ShXck/KROTIC-Code/InformeTecnico_MarceloSanchez.pdf

# Actualizacion de arquitectura para robot educativo ´ KROTIC

Marcelo Sanchez Solano ´
Area acad ´ | emica de Ingenier ´ | ía en Computadores
| Instituto Tecnologico de Costa Rica ´

Resumen—En este documento se describe el proceso de disenõ
de la solucion para la actualizaci ´ | on de la arquitectura del robot ´
educativo KROTIC. Se plantea que el robot ahora tiene dos niveles de funcionalidad separados y que realizan acciones distintas. El nivel superior maneja la transmision en vivo, procesamiento ´ de programas y mecanismos de control, mientras que el nivel inferior maneja funciones asociadas al movimiento y al uso de sensores. Para la solucion se analizan los factores fundamentales ´ que se deben tener en un robot, que son: costo, comunicacion, ´ sensores, autonomía y capacidad de procesamiento y luego, con base a los resultados se exponen las limitantes que el diseno tiene, ˜
que estan relacionadas al espacio f ´ | ísico, consumo energetico y ´
calidad de transmision en vivo de video. ´

Palabras clave—arquitectura, robot, costo, comunicacion, sen- ´ sores, autonomía y capacidad de procesamiento.

I. INTRODUCCION´
El laboratorio LuTec, que forma parte del Area Acad ´ | emica ´
de Ingeniería en Computadores en el Te, tiene el proyecto
KROTIC, donde el objetivo es ensenar fundamentos de rob ˜ | oti- ´
ca a estudiantes que residen zonas rurales donde al acceso a internet es limitado o de difícil acceso.
El robot KROTIC, es un pequeno cubo que debe ser ˜ programado por los estudiantes para que cruce una pista de
obstaculos. Entonces, el robot puede ser programado a trav ´ | es´
de una aplicacion m ´ | ovil para que el proceso sea lo m ´ | as sencillo ´
posible.
En primera instancia el proyecto se practicaba de forma presencial, donde se visitaban distintas escuelas y los ninos ˜ tenían interaccion directa con el robot que se programaba, pero ´ a raíz de la pandemia estas visitas se suspendieron, lo que llevo al surgimiento de nuevas necesidades de modo que estos ´ estudiantes no suspendan sus estudios en robotica. ´
La solucion que se propone en este documento viene a ´ solucionar parte de las necesidades que surgieron debido a la
pandemia. Es decir, la solucion abarca aspectos como conexi ´ | on´
inalambrica y despliegue de una visualizaci ´ | on a distancia de la ´
vista del robot. Ademas de m ´ | as capacidad de procesamiento y ´
mayor soporte para mas dispositivos como sensores, que viene ´
a dar mas posibilidades para la creaci ´ | on de programas de los ´
estudiantes.

II. ANTECEDENTES
Actualmente, los robots estan presentes en muchas ´ | areas ´
de aplicacion, desde sistemas rob ´ | oticos complejos como los ´
usados en exploraciones espaciales hasta los mas simples, ´ como los utilizados en aplicaciones de limpieza del hogar

[1]. Con el paso del tiempo, la capacidad de procesamiento de microcontroladores o dispositivos similares ha aumentado, mientras al mismo tiempo, su tamano se ha reducido. Esto hace ˜ que cada vez se puedan construir robots de menor tamano y ˜ mas baratos. ´
Asimismo, tales facilidades hacen que sea mas accesible ´
la implementacion de sistemas m ´ | as complejos como robots ´
cooperativos; que son multiples robots que tienen una tarea ´ en comun, pero que la misma tarea es distribuida entre la red ´ ya que sería muy difícil si no imposible de ser ejecutada por un solo robot [2], o enjambres de robots; donde un conjunto de robots forman estructuras similares a las encontradas en la naturaleza (abejas, aves, peces, entre otros) para resolver un problema específico [3], y por supuesto los robots educacionales tambien han tenido sus avances debido a todas las ´ facilidades que se mencionaron que se han desarrollado a lo
largo de los ultimos a ´ | nos. ˜
En [4], se desarrolla una aplicacion de robots enjambre ´
de proposito educativo, donde se ´ | nalan que cualquier robot ˜
educativo debe cumplir los siguientes requisitos:
1. Costo. Los robots deben ser los mas baratos posibles. ´
2. Autonomía. La batería debe ser suficiente para que los robots puedan operar por un largo tiempo.
3. Sistema de sensores. Deben estar equipados por componentes que permitan interactuar con su ambiente y captar eventos en el mismo.
4. Comunicacion. ´ Debe ser capaz de comunicarse con otros robots o con otros agentes externos.
5. Capacidad de procesamiento. Deben ser capaces de procesar la informacion captada por el sistema de sen- ´ sores mencionado.
Todas estas variables se consideraron para el diseno y ˜
seleccion de componentes y se va a detallar en la secci ´ | on´
de resultados.
Ahora, la pregunta es ¿Por que los robots pueden llegar ´ a ser tan relevantes en el area educativa? Los robots son ´ herramientas muy flexibles que pueden colaborar a mejorar el
entendimiento de muchas areas, no solo rob ´ | otica, puede utili- ´
zarse para aprender matematicas, f ´ | ísica, inteligencia artificial,
vision por computadoras, entre muchas otras. La ventaja del ´ aprendizaje asistido por robots es que ayuda a los estudiantes
a fortalecer sus conocimientos a traves de ejercicios pr ´ | acticos ´
[5].
De hecho, Benitti [6], al realizar un estudio sistematico ´ de literatura relacionada al aprendizaje a traves de robots, ´ concluyo que el uso de robots con fines educativos tiene mayor ´

influencia en los estudiantes en dos areas: contribuciones para ´ entender o asimilar conceptos y el desarrollo de habilidades. Por un lado, los descubrimientos de Benitti senalan que, a ˜ traves de ejercicios auto dirigidos promovieron el entendimien- ´ to de conceptos relacionados a la ciencia e ingeniería principalmente. Por otro lado, entre las habilidades desarrolladas se encuentran: i) el desarrollo de pensamiento, que se asocia
al observacion, estimaci ´ | on y manipulaci ´ | on, ii) resoluci ´ | on de ´
problemas, a traves de evaluaci ´ | on, generaci ´ | on de hip ´ | otesis, ´
verificacion de hip ´ | otesis y control de variables y iii) desarrollo ´
del trabajo en equipo.

III. SOLUCION DESARROLLADA ´

La solucion propuesta tiene dos niveles de funcionalidad, ´ que se derivan de los nuevos requerimientos mencionados al inicio, ya que se requiere mayor capacidad de procesamiento y extender las funcionalidades del robot KROTIC. A manera de resumen, el nivel superior de funcionalidad tienen las siguientes funciones:
Capturar videos e imagenes utilizando c ´ | amara USB. ´
Transmitir vía WiFi lo capturado por el modulo de ´ camara hacia los estudiantes en tiempo real. ´
Controlar las luces utilizadas por los programas de los estudiantes.
Llevar control de luces indicadores de algun evento. Por ´ el momento solo se contempla nivel bajo de batería y alta temperatura.
Manejar la peticion de datos de sensores al nivel inferior ´ cuando los programas así lo requieran.
Y el nivel inferior realiza las siguientes funciones: Controlar la captura de datos de sensores.
Controlar el movimiento de los robots a traves de servos. ´ Proveer de los valores leídos por los sensores al nivel superior cuando se requiera.
Un diagrama de bloques de la solucion final planteada se ´ muestra en la siguiente figura.

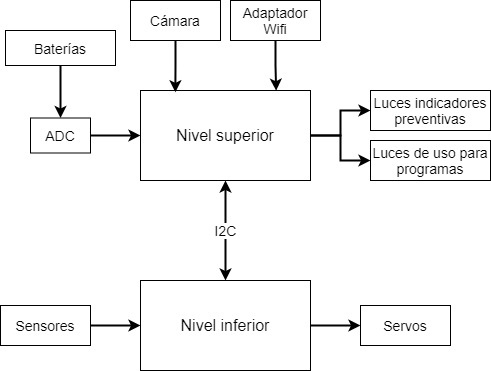
[picture p1: figure]

Fig. 1. Diagrama de bloques de la solucion´

III-A. Nivel superior
El componente principal de este nivel es la Raspberry Pi que se utiliza para controlar las funciones mencionadas. La Raspberry tiene bajo su control tres LEDs que son los que pueden ser controlados por los estudiantes, y 2 LEDs que son indicadores de batería baja. Cuando alguna de las baterías utilizadas baje de cierto nivel, el LED correspondiente empezara a parpadear para indicar que necesita un cambio. ´
Tambien tiene consigo un mecanismo de auto protecci ´ | on´
que, al detectar una alta temperatura, detenga operaciones y apague la tarjeta.
Con respecto a la captura de video, se utiliza una camara ´ USB pequena GEMBIRD y para su manejo se utilizan las ˜
bibliotecas fswebcam y motion. Esta ultima siendo la m ´ | as´
relevante, ya que es la responsable de la transmision en tiempo ´
real. Para la transmision tambi ´ | en es necesario el adaptador ´
EDUP EP-N8508GS USB 150 Mbps, ya que la version de ´
Raspberry que se esta utilizando no trae conexi ´ | on inal ´ | ambrica ´
por defecto.
Finalmente, toda comunicacion con el nivel inferior, se rea- ´ liza a traves del protocolo I ´ | 2C. La comunicacion con el nivel ´

inferior se hace para instruir a este nivel sobre las acciones a realizar, porque el nivel superior es el que maneja el programa de los estudiantes, pero esto es una característica que esta fuera ´ del alcance. Sin embargo, se definieron las instrucciones y la codificacion para cada una de las instrucciones o acciones que ´
estan disponibles con el dise ´ | no propuesto. ˜
La figura 2 muestra una imagen mas espec ´ | | ífica sobre la
distribucion de pines en la tarjeta para las funcionalidades ´ descritas.

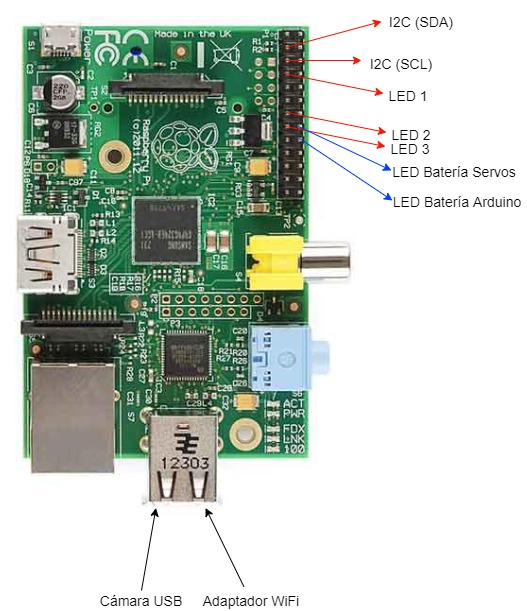
[picture p2: figure]

Fig. 2. Distribucion de pines en la Raspberry Pi. ´

III-B. Nivel inferior
Este nivel es controlado por una tarjeta Arduino UNO. El Arduino controla dos servos Parallax de rotacion continua, ´ que permite al robot desplazarse hacia adelante, atras y rotar ´ hacia la derecha e izquierda. Tambien, utiliza cuatro entradas ´
analogicas que est ´ | an destinadas a los sensores, aunque tambi ´ | en´

se pueden utilizar los pines digitales en modo de entrada, si fuera necesario. Las entradas analogicas restantes son utiliza- ´ das para los dos cables que requiere el protocolo I²C para comunicarse con la Raspberry (SDA y SCL).
Mencionar que, la Raspberry es el dispositivo maestro por lo que la conexion entre la Raspberry y el Arduino puede ´ ser directa. Si en otro caso se tuviera el Arduino como maestro se necesitaría un convertidor logico bidireccional para ´ transformar los 5 V que utiliza Arduino a un nivel de 3.3 V con el que trabaja Raspberry Pi, si se omite este detalle, se puede
llegar a danar la tarjeta, ya que la Raspberry no est ˜ | a equipada ´
para aguantar mas de 3.3 V en sus pines. Pero como Arduino ´ aguanta hasta 5 V, una entrada de 3.3 V no causa ningun da ´ no. ˜ Una imagen detallada de la distribucion de pines para el ´ Arduino se encuentra en la figura 3

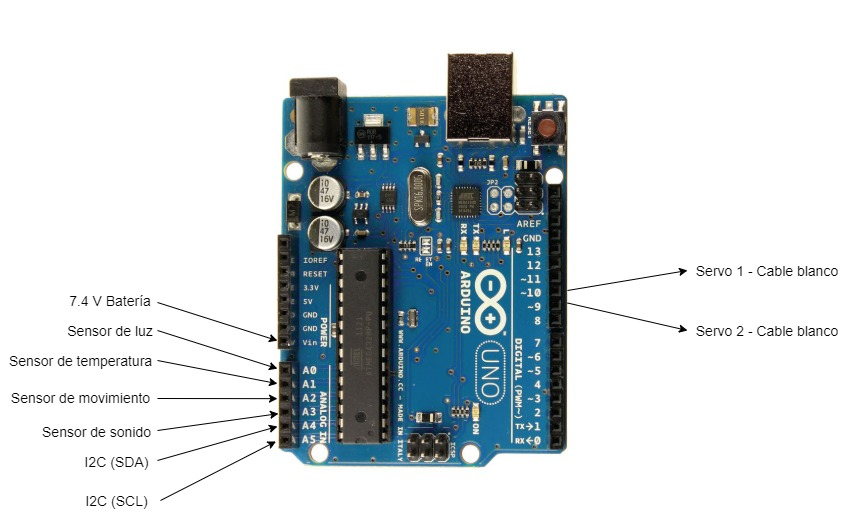
[picture p3: figure]

Fig. 3. Distribucion de pines en Arduino. ´

IV. RESULTADOS
Cuando se establecieron los requerimientos, se especi-
fico que las opciones de dise ´ | no deben tomar en cuenta las ˜
variables que se mencionaron en la seccion de antecedentes: ´
costo, comunicacion, autonom ´ | ía, capacidad de procesamiento
y sistema de sensores.

IV-A. Costo
En el plan de proyecto se establece un presupuesto total de $400, el diseno planteado apenas alcanza un porcentaje de ˜ alrededor un 40 %, tal y como se muestra en el desglose de la tabla I.
De hecho, el precio fue mucho menor, ya que muchos componentes ya se tenían disponibles en el laboratorio. Sin embargo, la idea es dar una perspectiva clara del costo total del diseno contra el presupuesto planteado desde un inicio. ˜

Cuadro I
Componentes de la arquitectura y su costo.
Componente | Cantidad | Costo conjunto
Raspberry Pi Model B. | 1 | $44.93
Arduino UNO. | 1 | $11.92
Modulo de c ´ amara de RPi. ´ | 1 | $19.74
Paquete de baterías 4xAA | 1 | $2.22
Baterías 18650 2000 mAh | 2 | $13.86
Holder para baterías 18650 | 2 | $2.19
Adaptador AC/DC 5V@3A | 1 | $6
Adaptador WiFi USB | 1 | $14.95
LEDs | 7 | $1.13
Resistencia de 220 Ohmios. | 7 | $1.13
Servo de rotacion continua ´ | 2 | $37.78
Convertidor analogico a digital ´ | 1 | $6
| Total | $161.85

IV-B. Comunicacion´

Como ya fue establecido, la comunicacion entre los dispo- ´ sitivos es a traves de I ´

2C, donde el nivel superior transmite comandos, que representan acciones y ademas, permite obtener ´ los valores de los sensores en algun instante. La idea es que, ´ eventualmente, estos valores sean transmitidos tambien a los ´
estudiantes, por lo que se quería que fueran lo mas peque ´ | nos ˜
posibles. En este caso el tamano m ˜ | aximo que necesitan los ´
datos es de 10 bits, lo cual representa un dato muy liviano,
incluso con la informacion adicional que se env ´ | | ía a la hora de
transmitirse.
El otro medio de conexion es a trav ´ | es de WiFi con los ´
estudiantes, que desean ver el robot ejecutar el programa que
ellos disenaron. Para la transmisi ˜ | on se ajustaron los par ´ | ametros ´
de modo la transmision sea lo m ´ | as fluida posible, es decir, la ´
resolucion no es de gran tama ´ | no (640x480) y los fotogramas ˜
se limitan a 15 fps. Recordar que los estudiantes pertenecen a zonas con limitado acceso a internet. y se quiere que el
proceso de ensenanza de fundamentos de rob ˜ | otica con una ´
modalidad remota no implique una disminucion en la calidad ´ de la ensenanza. ˜

IV-C. Autonomía

Autonomía se refiere al nivel de capacidad de utilizacion´ de baterías en un tiempo determinado para que el robot funcione sin ayuda externa. Se aseguro que cada uno de los ´ componentes tenga suficiente alimentacion para poder cumplir ´ sus funciones sin provocar inestabilidad debida a alimentacion´ insuficiente. Específicamente, los servos utilizan un paquete de cuatro baterías AA en serie. Lo que significa que si cada batería da 1.5 V, se tendran 6 V para alimentarlos, que es lo ´
recomendado por el fabricante. Ademas, las bater ´ | | ías soportan
los picos de corriente que producen los servos cuando se encuentran bajo algun tipo de carga. ´
Para el Arduino se utilizan dos baterías 18650 de 3.7 V en serie, produciendo 7.4 V a 2000 mAh. Si se utilizaran los nueve pines a su maxima capacidad de carga de forma ´ continua, que sería a 40 mA cada uno. Daría un total de 360 mA, lo que significa que no se descargaría la batería
incluso despues de una hora de utilizaci ´ | on continua m ´ | axima. ´
Que es un escenario poco posible, porque el robot no va a
estar en ejecucion continua, sino que est ´ | a activo solo cuando ´

los estudiantes envían algun programa, y la duraci ´ | on de esta ´
interaccion no es de m ´ | as de diez minutos. ´
Finalmente, para la Raspberry Pi se tiene planteado utilizar una batería de litio de 3.7 V a 2000 mAh, con un booster para llevar los 3.7 V a 5 V constantes que son los necesarios para que la tarjeta funcione correctamente. A 2000 mAh
y en utilizacion m ´ | axima, probablemente se logr ´ | e que dure ´
poco menos de una hora, ya que este es el componente con mayores requisitos de alimentacion, de igual forma recordar ´ que una ejecucion m ´ axima continua durante una hora, no es ´ un escenario probable.

IV-D. Sensores
Aunque la implementacion de los sensores que se quieren ´ utilizar en el robot no estan dentro del alcance de este ´ proyecto, se aseguro que las tarjetas de desarrollo tuvieran ´ la capacidad de integrar a los sensores en un futuro, como se mostro en la figura 3, ya se tiene definido que entradas pueden ´ ser utilizadas. Los sensores que se tiene pensando implementar en el futuro son cuatro: temperatura, sonido, movimiento y luz.

IV-E. Capacidad de procesamiento.
El objetivo de separar las funciones en dos tarjetas de desarrollo era aumentar las capacidades de procesamiento para que se desarrollen las acciones en dos componentes, cada uno con sus funciones bien definidas e independientes entre sí. Por un lado, en la Raspberry tiene funciones que manejan
la camara, la transmisi ´ | on en vivo y sistema de protecci ´ | on. ´
Mientras que, el Arduino realiza las acciones de movimiento y sensado principalmente. Entonces tener un mismo dispositivo que haga todas estas actividades puede ser posible, pero conforme surjan nuevos requerimientos puede ser que no se tengan las entradas necesarias disponibles porque ya estan´ ocupadas y se tenga que hacer esta division de todas formas. ´ Es decir, si se siguen agregando funcionalidades se puede llegar a ocupar la tarjeta en su totalidad, y esto representara una ´ carga muy elevada que se traduciría a un consumo energetico ´ alto que no permitiría al robot realizar varios programas sin quedarse sin batería rapidamente, lo que es una inconveniencia ´ al tener que estar recargando o reemplazando las baterías.
V. CONCLUSION´
Con este proyecto se tienen aportes, que benefician tanto a los estudiantes que haran uso del robot como para el futuro ´ desarrollo de la arquitectura del robot, estos son:
1. Interaccion m ´ | as directa entre el estudiante y el robot a ´
traves de la transmisi ´ | on en vivo. ´
2. Aumento considerable en la posibilidad de expansion´ de funcionalidad del robot. Al tener dos niveles de operacion aumentan las posibilidades de agregar otras ´ funcionalidades y dar mas flexibilidad a los programas ´ que pueden crear los ninos. ˜
3. El diseno incorpora un mecanismo visual que advierte ˜
sobre algun evento. Espec ´ | | íficamente sobre altas tempe-
raturas y niveles bajos de baterías.
4. Independencia de funciones entre un nivel y otro. La
unica interacci ´ | on que existe entre los dos componentes ´

principales es la transmision de datos de control y de ´ lectura de sensores.
Asimismo, la solucion propuesta tiene sus limitaciones: ´
1. El espacio físico con los nuevos componentes se ve limitado, al ahora tener dos tarjetas de desarrollo, se necesitan dos baterías para alimentarlos independientemente, sin mencionar el paquete de baterías que utilizan los servos. Esto puede llegar a limitar en cierta medida la movilidad del robot, por el peso que se agrega.
2. Relacionado al anterior, la forma de alimentacion puede ´ ser simplificada, se puede buscar una opcion que permita ´ compartir alimentacion entre dispositivos para disminuir ´
la ocupacion de espacio y el consumo energ ´ | etico. ´
3. La calidad de la imagen que provee la camara se ´ categoriza como intermedia-baja, permitiendo que el estudiante pueda visualizar lo que ocurre con el robot. Sin embargo, utilizando otras opciones como un modulo ´ de camara de Raspberry puede mejorarse la calidad de ´ la imagen.

REFERENCIAS

[1] Araujo, A., Portugal, D., Couceiro, M. S., & Rocha, R. P. (2014). ´ Integrating Arduino-Based Educational Mobile Robots in ROS. Journal of Intelligent & Robotic Systems, 77(2), 281–298. doi:10.1007/s10846-013-0007-4
[2] Lima, P. U., & Custodio, L. M. M. (2004). Artificial Intelligence and Systems Theory: Applied to Cooperative Robots. International Journal of Advanced Robotic Systems, 1(3), 15. doi:10.5772/5630
[3] Schranz M, Umlauft M, Sende M and Elmenreich W (2020) Swarm Robotic Behaviors and Current Applications. Front. Robot. AI 7:36. doi: 10.3389/frobt.2020.00036
[4] Couceiro, M. S., Figueiredo, C. M., Luz, J. M. A., Ferreira, N. M., & Rocha, R. P. (2012). A Low-Cost Educational Platform for Swarm Robotics. International Journal of Robots, Education & Art, 2(1).
[5] Lopez-Rodr ´ | íguez, F. M., & Cuesta, F. (2015). Andruino-A1: Low-Cost
Educational Mobile Robot Based on Android and Arduino. Journal of Intelligent & Robotic Systems, 81(1), 63–76. doi:10.1007/s10846-015-0227-x
[6] Benitti, F. B. V. (2012). Exploring the educational potential of robotics in schools: A systematic review. Computers & Education, 58(3), 978–988. doi:10.1016/j.compedu.2011.10.006
