ShXck/KROTIC-Code/Documento_de_Diseno_Updated.pdf

INSTITUTO TECNOLOGICO DE ´ | COSTA RICA
PROYECTO DE DISENO DE ˜ | INGENIERÍA EN COMPUTADORES
| CE-5302

# Documento de Diseno - KROTIC ˜ Architecture Upgrade

### Estudiante Marcelo Sanchez Solano ´

### Carné

2016115728

## Índice

1. Informacion general del documento | 2 ´
2. Historial de cambios | 2
3. Introduccion | 2 ´
3.1. Proposito | ´ | 2
4. Glosario | 3
5. Interesados | 4
6. Perspectivas de diseno | 4 ˜
6.2. Composicion | ´ | 5
6.3. Logica | ´ | 7
6.5. Informacion | ´ | 8
6.10.Interaccion | ´ | 10
6.11.Dinamica de estados | ´ | 11
7. Apendices | 12 ´
7.1. Apendice A. Alternativas de dise ´ | no | ˜ | 12
7.2. Apendice B. Comparaci ´ | on de propuestas de dise ´ | no | ˜ | 15
7.2.1. Seleccion de propuesta | ´ | | | 15
7.3. Apendice C. Tabla de tarjetas de desarrollo candidatas para implementaci ´ | on´ | 16

## 1. Informacion general del documento ´

Cuadro 1: Informacion general del documento. ´
Organizacion´ | Laboratorio LuTec.
Fecha de la version´ | 16/03/2021
Estatus | Preliminar.
Autor(es) | Marcelo Sanchez Solano. ´

## 2. Historial de cambios

Cuadro 2: Tabla de cambios del documento de diseno. ˜
Version´ | Fecha de version´ | Descripcion de cambios ´
1.0.0 | 09/03/2021 | Creacion inicial de estructura del documento y ´ redaccion de introducci ´ on. ´
1.0.1 | 10/03/2021 | Confeccion de diagramas de contexto y compo- ´ sicion. ´
1.0.2 | 11/03/2021 | Confeccion de diagramas de dependencias, pa- ´ trones, secuencia y estructural.
1.0.3 | 13/03/2021 | Diagramas de propuestas de solucion. ´
1.0.4 | 16/03/2021 | Actualizacion de diagramas de soluci ´ on y com- ´ paracion de propuestas. ´

## 3. Introduccion´

### 3.1. Proposito ´

El sistema KROTIC tiene como objetivo controlar todas las funciones que realiza un
robot, para que ninos de zonas alejadas puedan incursionar en el mundo de la rob ˜ | otica ´
incluso si no estan de forma presencial con el robot. Dado el contexto de la pandemia ´ mundial debido al COVID-19, el sistema se puede utilizar remotamente de modo que no se interrumpa el aprendizaje de conceptos de robotica. ´

### 3.2. Alcance

El funcionamiento de KROTIC se divide en dos partes: la parte de control de interaccion´
y transmision de datos, que es la encargada de comunicarse con el ni ´ | no remotamente. ˜
La otra parte se encarga de la ejecucion de las funciones que son programadas por los ´ estudiantes.

### 3.3. Contexto

Para la realizacion de este proyecto, el sistema KROTIC debe actualizarse debido al ´ surgimiento de nuevas necesidades que el diseno anterior no soporta completamente. Una ˜ de las mayores funcionalidades que se derivan es la necesidad de interaccion remota, dada ´ la emergencia sanitaria mundial. Por eso se requiere que las funcionalidades sean divididas de modo que la experiencia de aprendizaje no se vea afectada.

### 3.4. Resumen

El robot KROTIC es un robot de proposito educativo, dirigido a ni ´ | nos de zonas aleja- ˜
das donde los recursos tecnologicos son limitados. El robot sirve como base para que los ´ estudiantes de estas zonas puedan incursionar desde edades tempranas en la robotica y ´ puedan ejercitar los conocimientos de manera practica. ´
Los ninos aunque no est ˜ | en utilizando el robot f ´ | ísicamente, pueden ser capaces de desa-
rrollar sus programas y ejecutarlos remotamente. Ademas de poder ver el resultado de su ´
programa a traves de transmisi ´ | on desde el robot hacia el estudiante, con el objetivo de que ´
los ninos tengan retroalimentaci ˜ | on sobre las soluciones que fueron programadas. ´

## 4. Glosario

1. Fabrica abstracta. ´ | Patron de dise ´ | no creacional que produce familias de objetos rela- ˜
cionados (1).
2. Patron de dise ´ | no. ˜ | Soluciones generales a problemas comunes dentro del contexto
de software (2).
3. Retroalimentacion. ´ La salida o resultado de una parte del sistema es reintroducido de vuelta.

## Referencias

[1] Abstract Factory. Tomado de: https://refactoring.guru/es/design-patterns/abstract-factory (https://refactoring.guru/es/design-patterns/abstract-factory)
[2] Patrones de diseno. Tomado de: ˜ | https://refactoring.guru/es/design-patterns

## 5. Interesados

En la tabla 3 se muestran los actores interesados en el proyecto junto con los beneficios
que se obtienen por la realizacion del proyecto y los factores de inter ´ | es. ´

Cuadro 3: Valor e interes de cada interesado del proyecto. ´
Interesado | Valor | Interes´
Estudiante | Observar el programa desarro-llado por ellos mismos en fun-cionamiento de forma remota. | Aprender sobre principios basi- ´ cos de robotica y programaci ´ on. ´
Profesores | Permitir ensenar conceptos de ˜ robotica y programaci ´ on de for- ´ ma aplicada. | Evaluar los temas estudiados a traves de ejercicios pr ´ acticos. ´
Asistente de la-boratorio | Controlar el sistema para el fun-cionamiento de KROTIC | Asistir en el proceso de aprendi-zaje de los ninos desde el labo- ˜ ratorio.
Desarrollador de la arquitec-tura | Provee de las herramientas ne-cesarias para que los estudian-tes puedan desarrollar y ejecu-tar sus programas de forma re-mota. | Aprender sobre los componen-tes de un sistema de robotica y ´ circuitos empotrados.
Instituto Tec-nologico de ´ Costa Rica | Contribuir con el aprendizaje de principios de robotica en zonas ´ lejanas y recursos limitados. | Promover el aprendizaje de te-mas relevantes actuales, como lo es la robotica y la programa- ´ cion. ´

## 6. Perspectivas de disenõ

### 6.1. Contexto

El diagrama de la figura 1 muestra todas las interacciones del diseno de la arquitectura ˜ del robot KROTIC. Por un lado se tiene el aspecto de personal, que consta del asistente de
laboratorio; que sera el encargado de realizar la configuraci ´ | on inicial del robot. El asistente ´
es el unico usuario que tiene interacci ´ | on directa con la arquitectura del robot. ´
Por otro lado, se tienen los aspectos de operacion y funcionalidad. A continuaci ´ | on se ´
explican las partes involucradas:
1. Sensores. Cuatro tipos de sensores que pueden ser utilizados por separado y a conveniencia por los estudiantes que crean el programa que se ejecuta en la arquitectura.
2. Luces. Similar a los sensores, las luces responden a acciones estipuladas en el programa de los estudiantes. Los programas soportan las acciones basicas de encendido ´ y apagado.

3. Modulo de conexi ´ | on inal ´ | ambrica. ´ | Este componente es el encargado de la transmi-
sion y recepci ´ | on de datos de los estudiantes. Se utiliza para dar la retroalimentaci ´ | on a ´
los estudiantes sobre el resultado del programa enviado.
4. Camara. ´ | Componente propio del robot, que esta destinado a capturar la vista en pri- ´
mera persona de las acciones que realiza el robot para luego ser transmitida a los estudiantes.
5. Servos. Son los componentes que controlan las acciones de movimiento del robot.

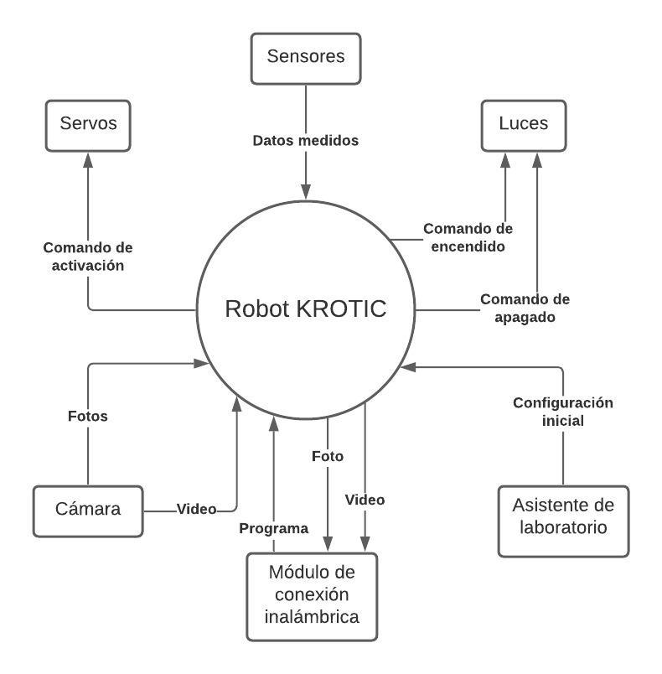
[picture p8: figure]

Figura 1: Diagrama de contexto del sistema.

### 6.2. Composicion´

En este caso, se observa que en la figura 2 se desglosan las dos partes de la arquitectura
que manejan el uso de datos, comunicacion y funcionalidad. A continuaci ´ | on se explican las ´
partes del diagrama, sin incluir aquellas partes que ya fueron explicadas en el diagrama de contexto.

Unidades de procesamiento. Son las encargadas de manejar comunicacion interna, ´ es decir, transmision de datos entre las diferentes unidades y se encargan de manejar ´ los dispositivos conectadas a ellas.

Modulo de protecci ´ | on. ´ | Proteccion contra eventos que pongan en peligro la integridad ´
y funcionalidad del robot.

Sensores. Captura de diferentes factores del entorno.

Nivel superior. Controla la camara, transmisi ´ | on de fotos y videos y recepci ´ | on de datos ´
del estudiante.

Nivel inferior. Encargado de controlar sensores, componentes de movimiento y proteccion de los dispositivos. ´

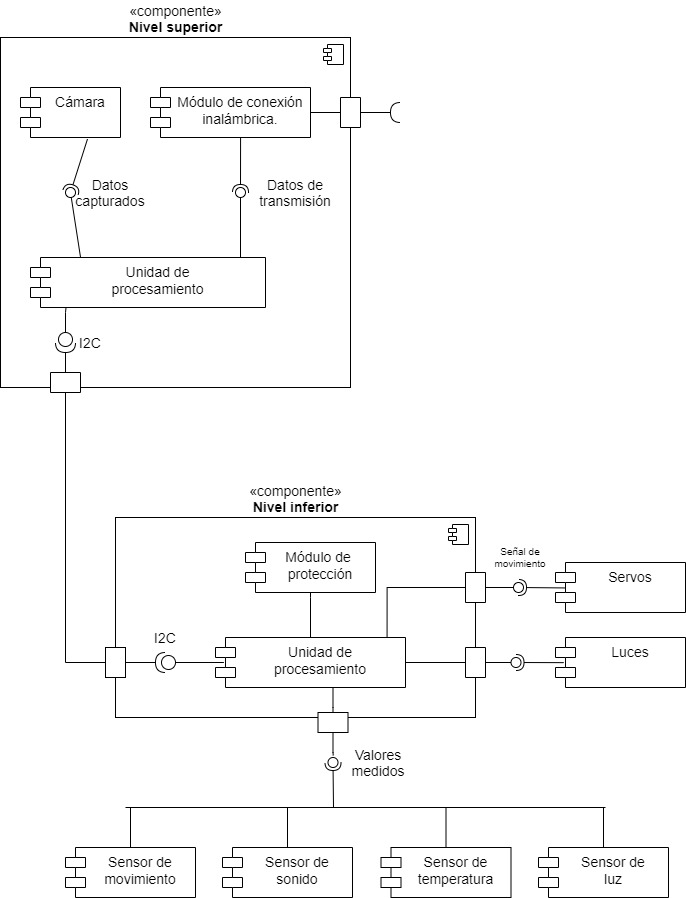
[picture p9: figure]

Figura 2: Diagrama de composicion del sistema. ´

### 6.3. Logica ´

No aplica.

### 6.4. Dependencias

En el caso del modelo de dependencias de la figura 3, aparte de los componentes ya
visualizados en el diagrama de composicion (figura 2), se especifican m ´ | odulos de manejo ´
de funciones internas de las placas de desarrollo que se utilicen:
1. Receptor de programa. Unidad que se basa la comunicacion inal ´ ambrica para recibir ´ los programas de los estudiantes.
2. Unidad de planificacion. ´ | Al recibir el programa, procesara las instrucciones del pro- ´
grama y dividira las tareas. Por ejemplo, las instrucciones se podr ´ | | | ían dividir en ins-
trucciones mas peque ´ | nas y at ˜ | omicas que resultan en un manejo m ´ | as eficiente de los ´
recursos computacionales. Una vez que se planifiquen, se comunican las acciones finales al nivel de funcionalidad.
3. Unidad de procesamiento multimedia. Modulo de procesamiento de los datos toma- ´ dos por la camara. ´
4. Modulo de comunicaci ´ | on interna ´ | . La comunicacion interna hace referencia a la co- ´
nexion entre el nivel superior con el inferior. Este m ´ | odulo comunica las acciones que ´
se deben realizar con respecto a movimiento, mediciones y control de luces.
5. Modulo de protecci ´ | on. ´ | Consiste en una unidad de monitoreo de variables que pue-
dan poner en peligro a los componentes. Se incluyen situaciones como baja batería y sobrecalentamiento del dispositivo principal.
6. Modulo de temporizaci ´ | on. ´ | Encargado de temporizar acciones y es activado a traves´
de instrucciones de los programas de estudiantes.
7. Modulo de ejecuci ´ | on. ´ | Encargado de controlar todos los componentes funcionales
externos, como sensores, servos y luces.

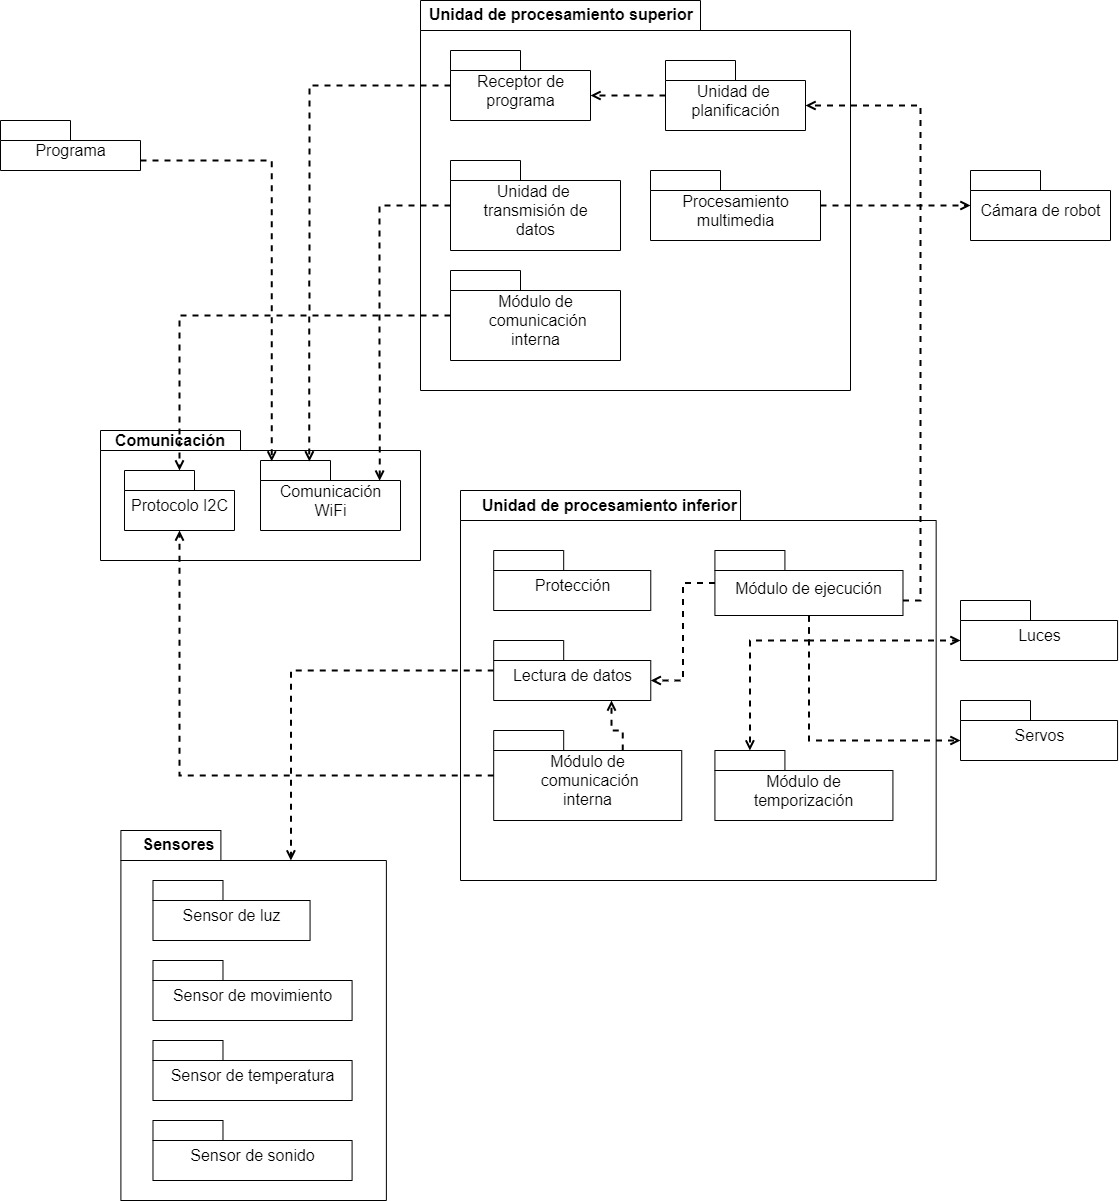
[picture p10: figure]

Figura 3: Diagrama de paquetes del sistema.

### 6.5. Informacion´

No aplica.

### 6.6. Uso de patrones

Para este proyecto, el patron de dise ´ | no de f ˜ | abrica abstracta se aplica en el nivel superior ´
de funcionalidad. Específicamente, se utilizara al procesar las instrucciones que se deben ´ ejecutar en el robot. De modo que para cada una de las acciones se utilice un solo codigo ´
para ejecutar la logica interna de la instrucci ´ | on en lugar de crear c ´ | odigo especializado para ´
cada una de las instrucciones, esto produciría un codigo poco escalable, en caso de que se ´ agreguen mas comandos en el futuro. El diagrama de clases que se propone se muestra en ´ la figura 4.
En caso de que se necesiten agregar mas instrucciones, solo se necesita crear la clase ´
que maneja dicha instruccion y hacerla heredar de la clase abstracta. Adem ´ | as de imple- ´
mentar las acciones que ejecutan cuando se necesita activar la instruccion. ´

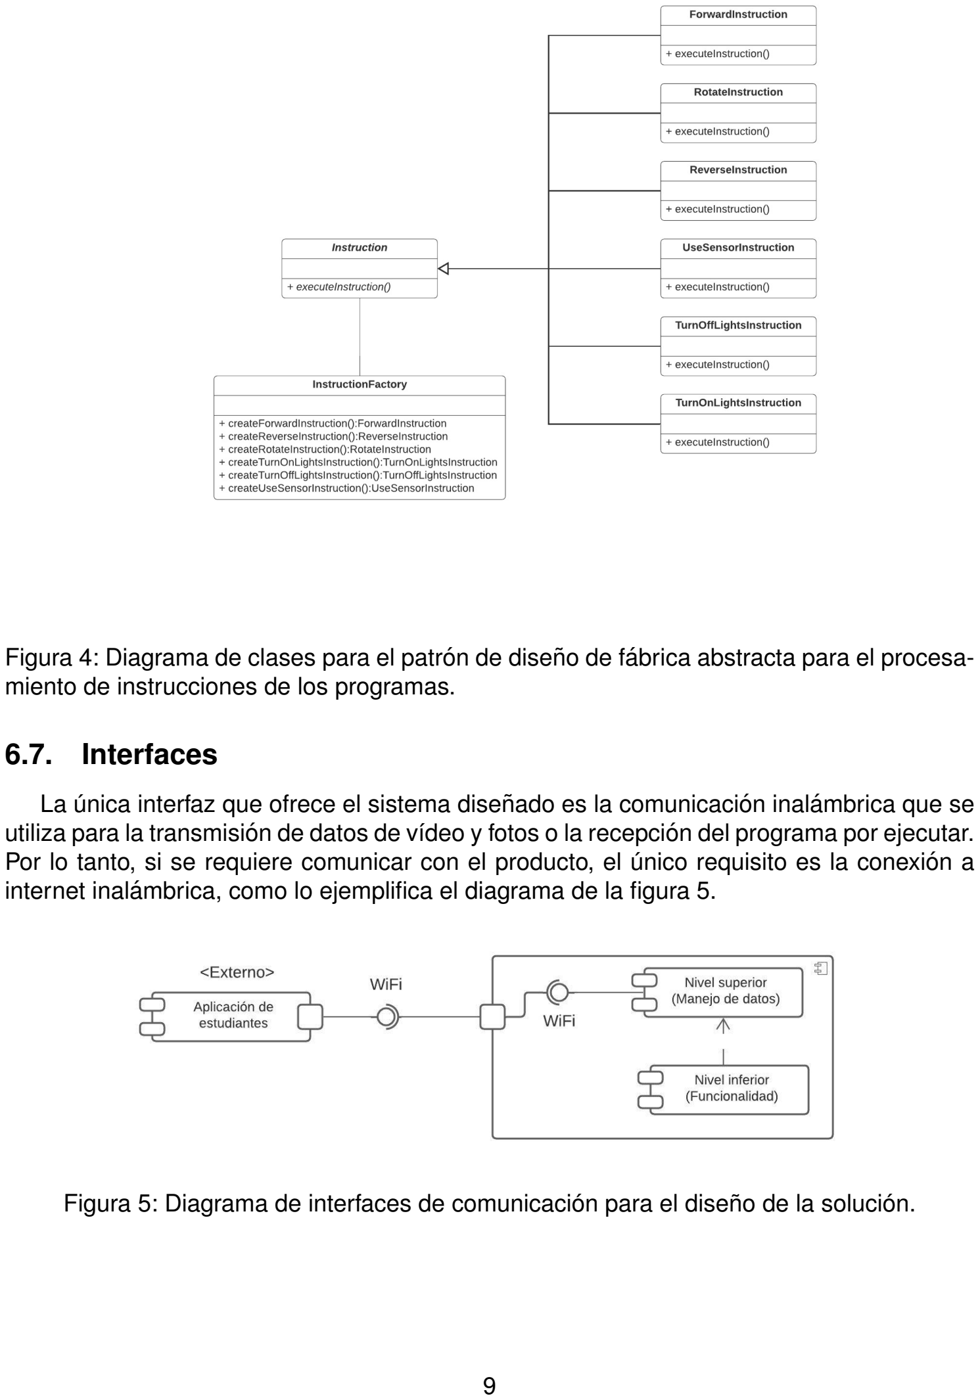
[picture p11: page 10]

Figura 4: Diagrama de clases para el patron de dise ´ | no de f ˜ | abrica abstracta para el procesa- ´
miento de instrucciones de los programas.

### 6.7. Interfaces

La unica interfaz que ofrece el sistema dise ´ | nado es la comunicaci ˜ | on inal ´ | ambrica que se ´
utiliza para la transmision de datos de v ´ | ídeo y fotos o la recepcion del programa por ejecutar. ´
Por lo tanto, si se requiere comunicar con el producto, el unico requisito es la conexi ´ | on a ´
internet inalambrica, como lo ejemplifica el diagrama de la figura 5. ´
Figura 5: Diagrama de interfaces de comunicacion para el dise ´ | no de la soluci ˜ | on. ´

### 6.8. Interfaces de usuario

No aplica.

### 6.9. Estructura

Para el diagrama de estructura de la figura 6 se especifican los componentes estruc-
turales basicos de la arquitectura. Para la parte inferior, se tienen todos los m ´ | odulos de ´
medicion, luces, temporizadores y servos. En el nivel superior los bloques principales son ´
el modulo de comunicaci ´ | on inal ´ | ambrica y la c ´ | amara del robot. ´

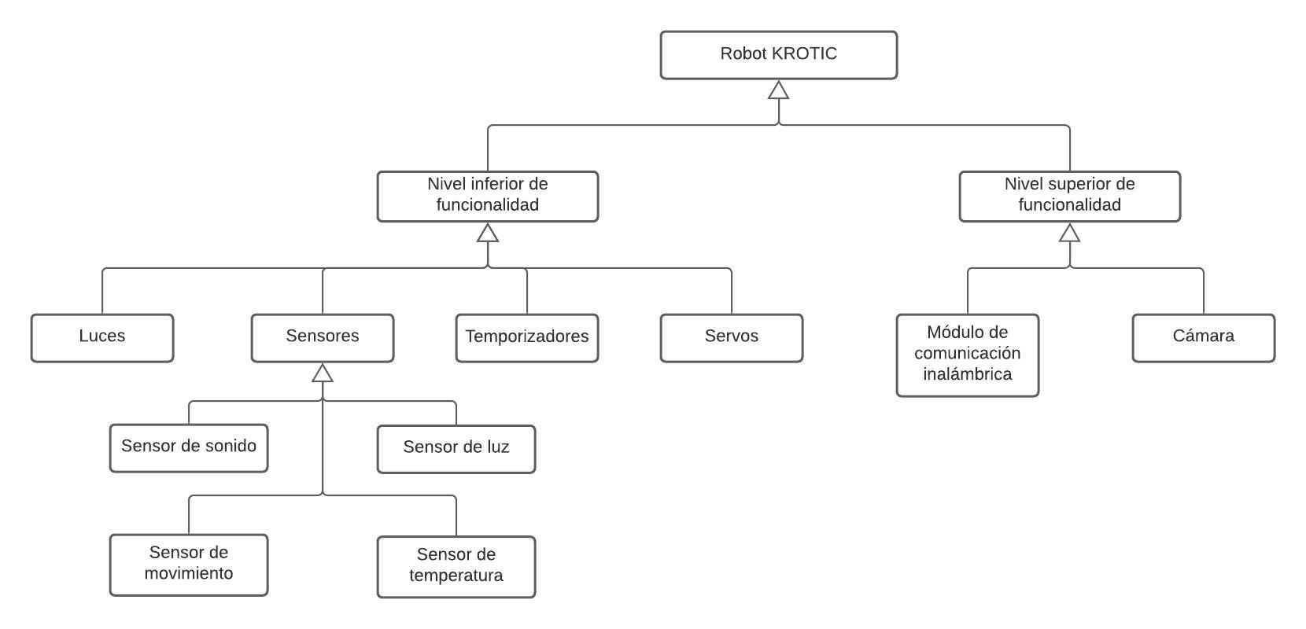
[picture p12: figure]

Figura 6: Diagrama de estructura del sistema.

### 6.10. Interaccion´

En el diagrama de secuencia de la figura 7 se observa que el proceso inicia cuando se detecta un programa proveniente de los estudiantes. Primero, el nivel superior de funcio-
nalidad tomara el programa y planificar ´ | a las acciones exactas a realizar. El nivel superior ´
empezara a enviar las instrucciones de forma serial y al mismo tiempo activar ´ | a la c ´ | amara ´
para documentar y transmitir las acciones que estan siendo ejecutadas por el robot. ´
Luego, el nivel inferior de funcionalidad activara los m ´ | odulos de ´ | hardware que sean re-
queridos por las instrucciones. Si los sensores son utilizados, los valores medidos son reportados de vuelta al nivel superior para ser transmitidos. El flujo finaliza cuando el programa es ejecutado por completo.

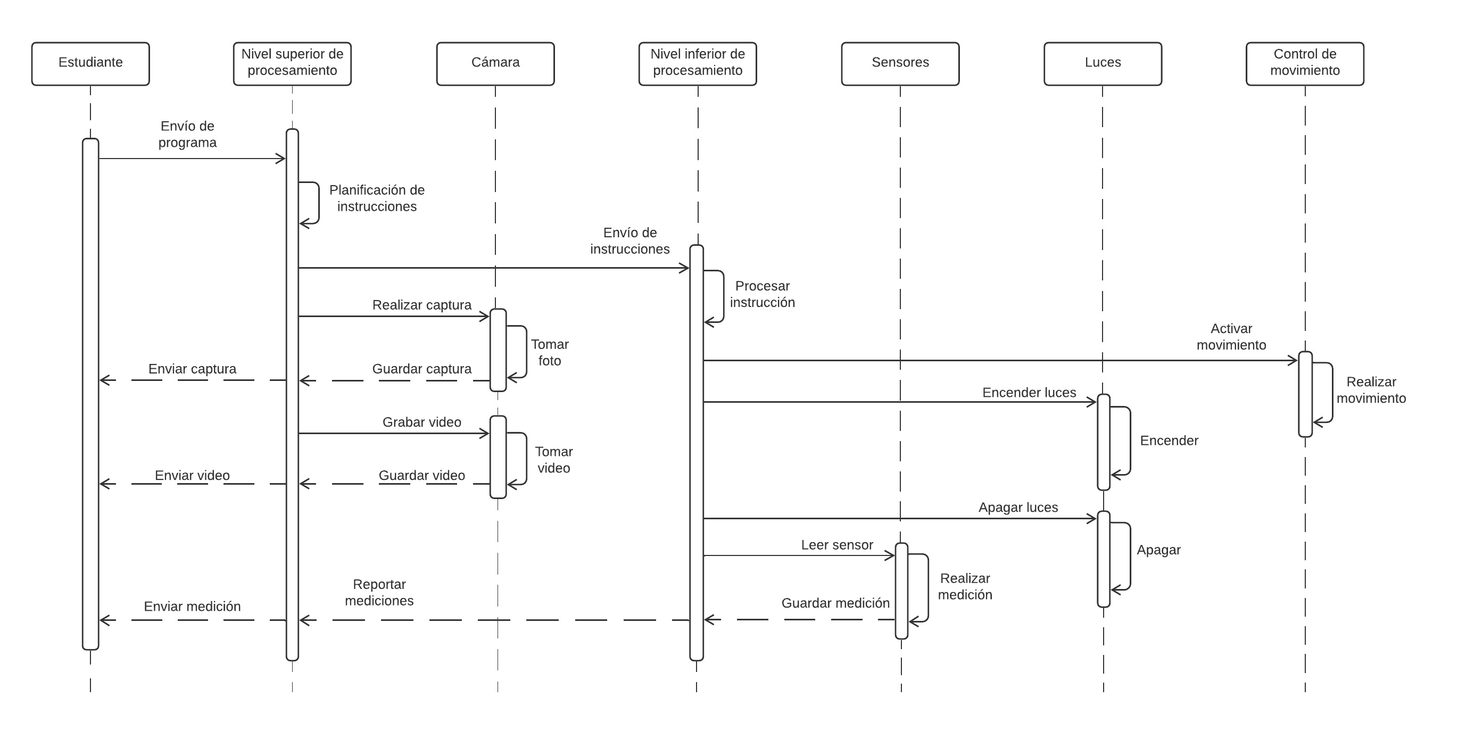
[picture p13: figure]

Figura 7: Diagrama de secuencia para la ejecucion de un programa en la arquitectura. ´

### 6.11. Dinamica de estados ´

No se documenta.

### 6.12. Algoritmos

No aplica.

### 6.13. Recursos

No se documenta.

## 7. Apendices ´

7.1. Apendice A. Alternativas de dise ´ | nõ
Para cada una de las alternativas de diseno, los factores que se consideraron m ˜ | as cr ´ | íti-
cos son: consumo energetico, tama ´ | no y peso. En la tabla 4, se incluyen otros factores de ˜
importancia como capacidad de procesamiento y soporte de entradas.
Para los aspectos de tamano y peso, se refieren a las limitaciones f ˜ | ísicas del robot. El
robot es un cubo de quince centímetros (15 cm) de lado, por lo tanto es necesario considerar el tamano de los componentes que se vayan a utilizar. Para el peso se debe considerar que ˜ el conjunto de componentes no dificulte el movimiento con los motores que actualmente se tienen.
El consumo energetico parte de la base de que se quiere que el robot sea amigable con ´
el ambiente. Asimismo, el tamano de la bater ˜ | ía que se defina tambien influye en el peso y ´
espacio de ocupacion. Por lo que se quiere que sea la menor posible para realizar todas las ´ funciones.

### 7.1.1. Propuesta de dos niveles simple

Para la propuesta de la figura 8, se tiene la solucion m ´ | as b ´ | asica del conjunto. Esta ´
consta de unicamente dos niveles, donde el nivel superior de funcionalidad es el encargado ´
de manejar los datos percibidos por la camara y de la transmisi ´ | on de video y fotos hacia ´
el estudiante. El nivel inferior se encargara del manejo de sensores, temporizadores, luces ´
y movimiento del robot. La comunicacion entre ambos niveles es a trav ´ | es de I ´

2C, que se
utiliza para intercambio de instrucciones, así como reporte de mediciones de los sensores.
El convertidor de analogico a digital se utiliza para leer los valores de nivel de bater ´ | ía y
pasarselos a la Raspberry Pi, de modo que se utilicen las luces indicadores, de modo que ´ se enciendan cuando alguna de las baterías se encuentra cerca de dejar de ser util para ´ que pueda ser recargada o reemplazada.

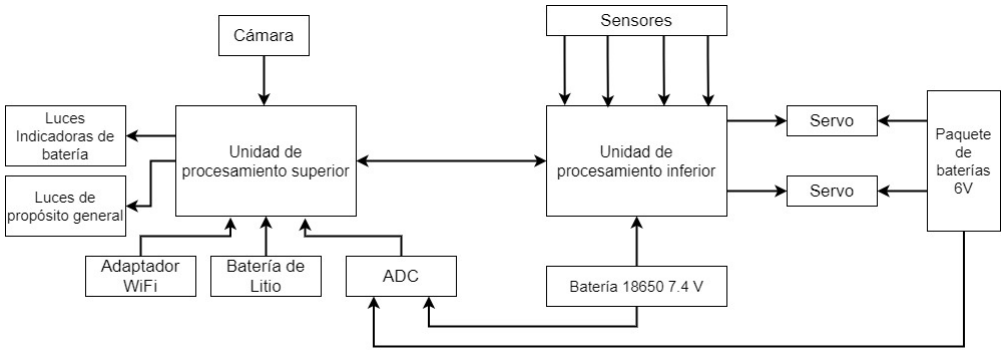
[picture p14: figure]

Figura 8: Diagrama de bloques para la propuesta de dos niveles simple.

### 7.1.2. Propuesta de dos niveles con nivel inferior separado

En la solucion de la figura 9, se observa que en este caso, el nivel inferior de funcionali- ´ dad se divide con el proposito de especializar las unidades que componen el nivel. Por un ´ lado, una unidad de procesamiento se encarga de la mayor parte de control de sensores y uso de temporizador y por otro lado, la unidad secundaria se encarga del movimiento, luces y del sensor de luz.
A diferencia de la primera alternativa, el nivel inferior no se encuentra tan saturado de componentes. Sin embargo, el consumo energetico se ve incrementado, el espacio requeri- ´
do tambien aumenta, as ´ | í como el peso. Aun as ´ | í, la capacidad de procesamiento y soporte
de dispositivas aumenta significativamente.

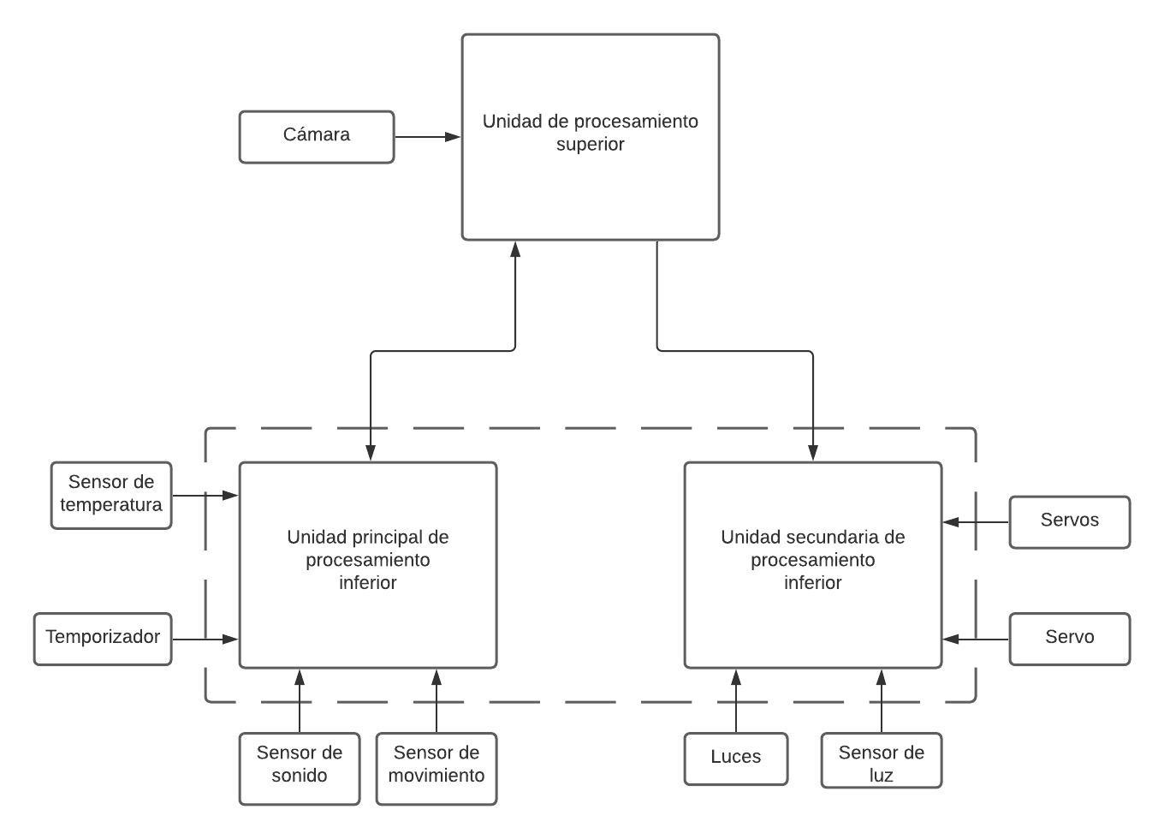
[picture p15: figure]

Figura 9: Diagrama de bloques para la propuesta de dos niveles con separacion del nivel ´ inferior.

### 7.1.3. Propuesta de dos niveles con unidad intermediaria de control

Para la tercera propuesta se introduce una unidad intermediaria entre los niveles. Esta unidad funciona como centro de control para las funcionalidades de todos los otros niveles. Es el encargado de recibir los programas a ser ejecutados y con base a eso, se comunican las operaciones respectivas que debe realizar cada unidad. Es el punto intermediario de intercambio de datos entre los niveles.
Tambien, se piensa que si en un futuro se agregan ´ | n cantidad de niveles adicionales,
esta unidad de control puede reducir la complejidad de comunicacion entre los niveles. De ´
modo que se tenga un solo canal de comunicacion centralizado en lugar de tener ´ | n canales.
Similar a la segunda propuesta, al agregar una unidad, el consumo se ve afectado negativamente, igual como el peso aumenta. Una desventaja que posee cuando se compara con la segunda propuesta es que no aumenta la cantidad de entradas soportadas, ya que el proposito de la unidad no es manejar componentes externos como sensores, sino servir ´ como canal de comunicacion centralizado. ´

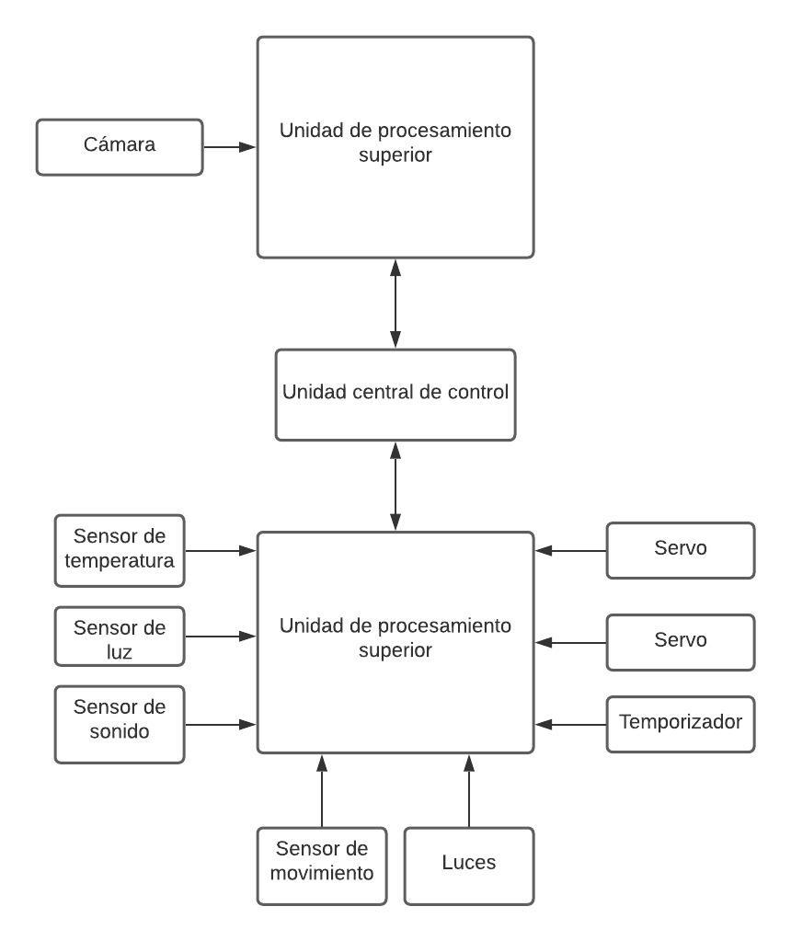
[picture p16: figure]

Figura 10: Diagrama de bloques para la propuesta de dos niveles utilizando una unidad intermediaria de control

7.2. Apendice B. Comparaci ´ | on de propuestas de dise ´ | nõ

Cuadro 4: Tabla de comparacion de propuestas ´
Propuesta | Consumo | Tamanõ | Peso | Soporte de entra-das | Procesamiento
Simple de dos niveles. | Moderado. | Moderado. | El peso no limita las funcionali-dades de movimien-to. | Intermedio. Depende de las tarjetas de desarrollo. | Intermedio. Se divide unica- ´ mente entre dos niveles.
Nivel inferior di-vidido. | Incrementa con res-pecto a la propuesta simple. | Incrementa con res-pecto a la propuesta simple. | Incrementa con res-pecto a la propuesta simple. Sin limitar las funcio-nalidades de mo-vimiento significati-vamente. | Aumenta significa-tivamente con res-pecto a la propuesta simple. | Aumenta sig-nificativamente con respecto a la propuesta simple.
Unidad interme-diaria. | Incrementa con res-pecto a la propuesta simple. | Incrementa con res-pecto a la propuesta simple. | Incrementa ligeramen-te con respecto a la pro-puesta simple, de modo que no limita el movi-miento del robot. | No cambia con res-pecto a la propuesta simple. | Aumenta ligera-mente con res-pecto a la pro-puesta simple.

### 7.2.1. Seleccion de propuesta ´

Basandose en los datos de la tabla 4, los dise ´ | nos que se presentan favorables son: la ˜
propuesta simple de dos niveles y la propuesta de dos niveles con nivel inferior dividido. La propuesta con unidad intermediaria no presenta muchos beneficios con respecto a las otras
dos propuestas que puedan ser de inmediata utilidad, como se discutio en la secci ´ | on 7.1.3, ´
la utilidad de esta propuesta vendría a ser considerable si existiera una mayor cantidad de unidades.

Entonces, dadas las restricciones de espacio físico principalmente, que por lo tanto afecta la autonomía del robot, se ha elegido la opcion simple de dos niveles para implementar ´ en el prototipo. Para este prototipo se utilizara una Raspberry Pi para el nivel superior y un ´ Arduino UNO para el nivel inferior ya que poseen las herramientas mas convenientes para ´ implementar el prototipo y ademas son los componentes con los que se tiene mayor docu- ´
mentacion externa, por lo tanto, la ubicaci ´ | on de informaci ´ | on ser ´ | a f ´ acil incluso para aquellos ´
que manejen la arquitectura por primera vez.
En cuanto a implementacion, referirse al ap ´ | endice C, donde se muestra una tabla com- ´
parativa con las posibles opciones para las tarjetas de desarrollo que seran las unidades ´ principales para cada nivel. En la tabla se muestran otros atributos de interes para el siste- ´ ma, como la alimentacion, memoria, cantidad de pines, entre otros. ´

### 7.3. Apendice C. Tabla de tarjetas de desarrollo candidatas para im- ´ plementacion´

Cuadro 5: Características de tarjetas de desarrollo candidatas para la implementacion. ´
Dispositivo | Alimentacion´ | Memoria | Puertos totales | Precio aproximado
Raspberry Pi 3 B+ | 2.5A/5V | 1 GB | 40 | $40
Raspberry Pi 4 | 3A/5V | 2/4/8 GB | 40 | $52
BeagleBone Black | 2A/5V | 512 MB | 69 | $35-$80
ASUS Tinker Board S | 3A/5V | 2 GB | 28 | $95
Arduino Mega | 7-12V | 8 KB | 54 | $40
Rock64 | 3A/5V | 4 GB | 40 | $45
Odroid-XU4 | 4A/5V | 2 GB | 38 | $100
