ShXck/KROTIC-Code/BLOCK_DIAGRAM_PROTOTYPE.jpg

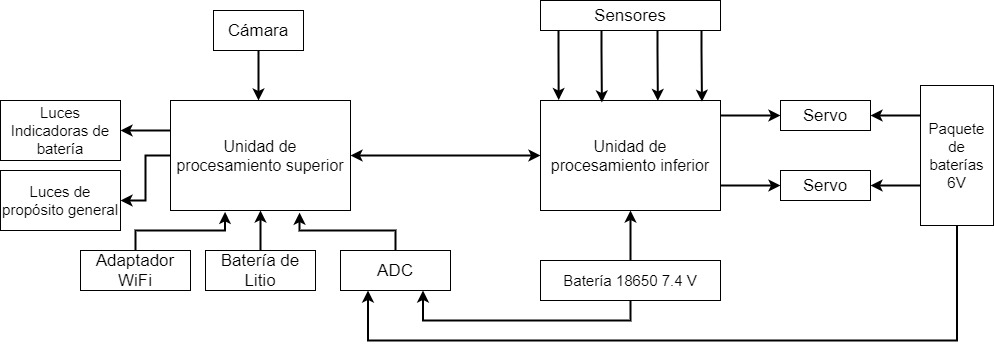
BLOCK_DIAGRAM_PROTOTYPE.jpg
