ShXck/KROTIC-Code/Schematic_esquemático.jpg

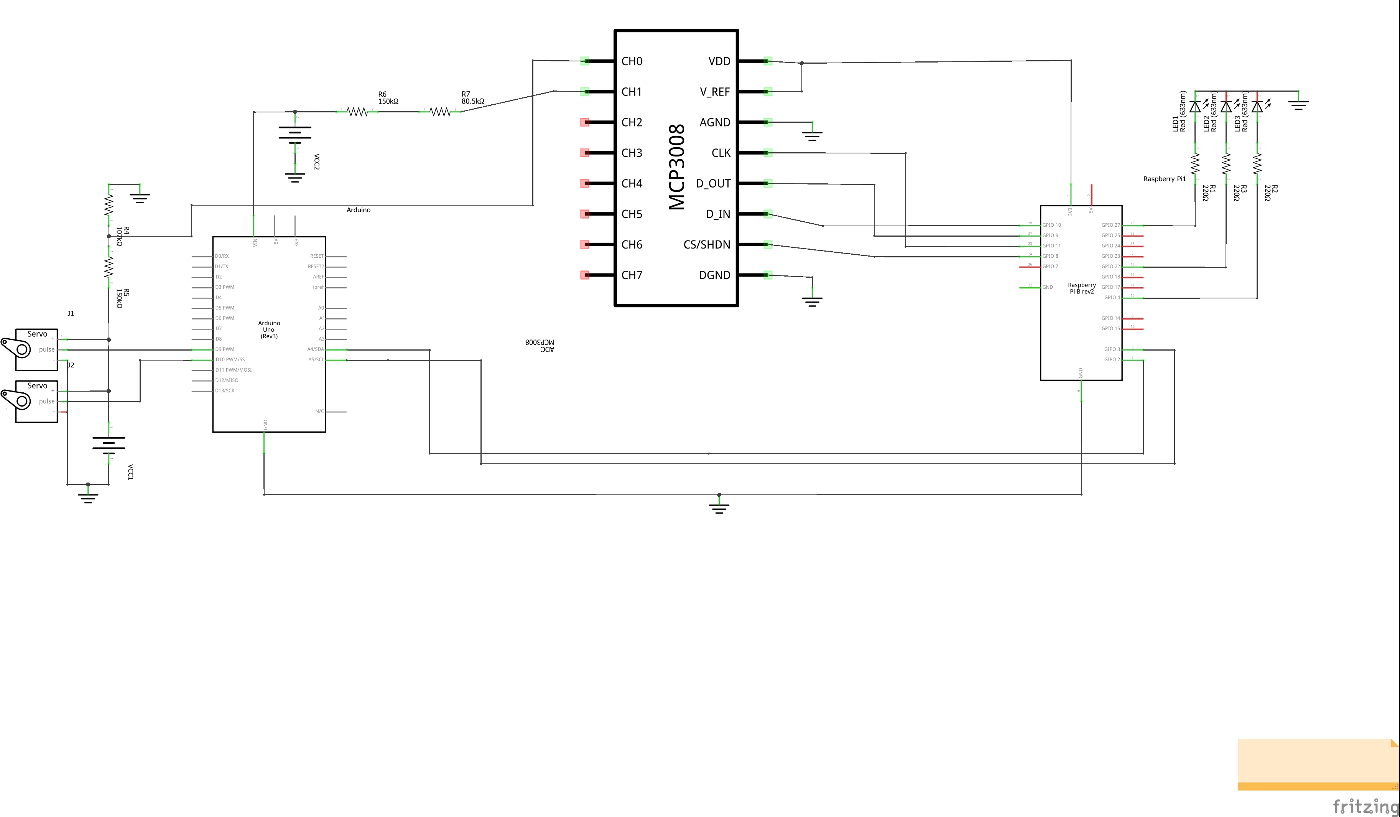
Schematic_esquemático.jpg
