ShXck/KROTIC-Code/KROTIC_Manual.pdf

INSTITUTO TECNOLOGICO DE ´ | COSTA RICA

### LABORATORIO LUTEC

# Manual de arquitectura de robot KROTIC

## Índice

1. Distribucion de pines | 2 ´
1.1. Distribucion de pines nivel inferior | ´ | 2
1.2. Distribucion de pines nivel superior | ´ | 2
2. Comunicacion I2C | 4 ´
3. Medicion de temperatura | 5 ´
4. Transmision en vivo | 5 ´
5. Manejo de camara | 6 ´
6. Manejo de entradas analogicas en la Raspberry Pi | 6 ´
7. Consumo y fuentes de alimentacion | 7 ´
8. Regulacion de voltaje | 8 ´

## 1. Distribucion de pines ´

Esta seccion describe la distribuci ´ | on de pines en cada una de las tarjetas que se utilizan ´
en la arquitectura de una forma grafica y m ´ | as sencilla que lo observado en el esquem ´ | atico. ´

### 1.1. Distribucion de pines nivel inferior ´


Figura 1: Distribucion de pines nivel inferior. ´

Se tiene que, las entradas del ADC de la 0 a la 3 estan ocupadas por los sensores ´ del robot. Importante recordar que el Arduino no puede recibir en ninguno de sus pines (a excepcion de la entrada Vin), un voltaje mayor a 5V, por lo que so alguno de los sensores ´ supera este valor debe ser regulado.
Si se fuera a reemplazar la batería, recordar que el Arduino admite en su pin Vin valores entre 6 - 20 V. Sin embargo, lo recomendable es usar valores entre 7 - 12 V. Si se baja de eso puede provocar inestabilidad en la tarjeta y si se supera puede sobre calentar el regulador y danarlo eventualmente. ˜
Finalmente, Los pines A4 y A5 son reservados para la comunicacion I ´

2C y los pines
digitales 9 y 10 son para enviar senales a los servos. ˜

### 1.2. Distribucion de pines nivel superior ´

El nivel superior, que es manejado por una Raspberry Pi, como la mostrada en la figura
2. En su mayoría se encargar de controlar LEDs que pueden ser los tres que los estudiantes
pueden manejar con el codigo o los de control, que son indicadores del estado de la bater ´ | ía


Figura 2: Distribucion de pines nivel superior. ´

de los servos y del Arduino. Cuando el nivel de batería sobre pase cierto nivel los LEDs empezaran a parpadear. ´
Al igual que en el caso de Arduino, tener en cuenta la logica que maneja la tarjeta, ´ la Raspberry Pi maneja un nivel a 3.3 V, por lo que ninguno de sus pines debería recibir
mas de eso, porque se podr ´ | ía danar la tarjeta. Por eso es que si se conectan dispositivos ˜
adicionales debera regularse si es necesario. ´
En este nivel tambien se contempla, el uso de una c ´ | amara USB y el adaptador WiFi en ´
ambos puertos USB.

### 1.3. Referencia de pines

Para futura referencia y para el codigo de prueba de python, tomar como referencia ´ la siguiente figura, que contiene los pines con referencia al numero en la tarjeta y las ´
referencias segun est ´ | an definidos en el procesador. En el c ´ | odigo de prueba se definen ´
los pines como referencia a la tarjeta, y esto en el codigo se observa en el comando ´
GPIO.setmode(GPIO.BOARD), para esta configuracion se utilizan los n ´ | umeros que est ´ | an al ´
lado del nombre del pin en la figura 3, si se elige la otra referencia se tendría que especificar
como GPIO.setmode(GPIO.BCM) y los numeros que se ponen son los n ´ | umeros del GPIO. ´

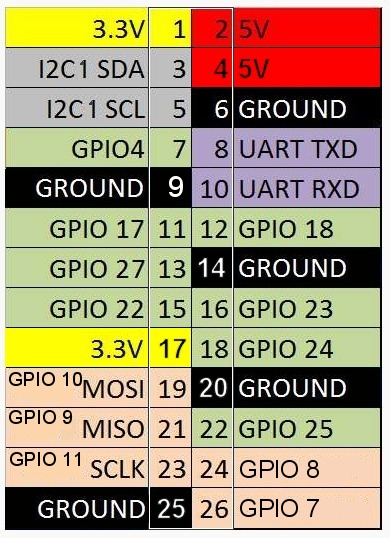
[picture p19: figure]

Figura 3: Distribucion de pines Raspberry Pi. ´

## 2. Comunicacion I2C ´

La mayor consideracion que hay que tener en mente es que las dos tarjetas trabajan a ´
niveles logicos distintos, como ya se mencion ´ | o el Arduino funciona con 5V y la Raspberry a ´
3.3V. En este caso la comunicacion I ´ | 2C se puede realizar conectando los cables de SDA y
SCL directamente en cada tarjeta sin ningun problema porque la Raspberry es el maestro, y ´
este es el que define el nivel logico del bus. Entonces el arduino estar ´ | a recibiendo alrededor ´
de 3.3V en sus pines cuando exista comunicacion, lo cual no es problema porque tiene un ´ límite de 5V.
En caso de que se necesite cambiar esta configuracion; es decir, el Arduino es maestro ´ y la Raspberry esclavo, no se puede realizar una conexion directa porque la Raspberry ´
estaría recibiendo mas de 3.3V en sus pines y por lo tanto, da ´ | nãndola. Si se quisiera hacer ´
esta configuracion, es necesario un componente extra, un convertidor l ´ | ogico bidireccional ´
como el de la figura 4 para poder bajar el nivel de 5V a 3.3V.

Figura 4: Convertidor logico bidireccional. ´

### 2.1. Instrucciones I²C

Las instrucciones que se envían desde la Raspberry al Arduino estan codificadas con- ´ forme la siguiente tabla.

Cuadro 1: Instrucciones para el protocolo I²C
Instruccion´ | Variable en codigo Arduino ´ | Valor I²C
Leer sensor de luz. | READ LIGHT INSTR | 0x0
Leer sensor de temperatura. | READ TEMP INSTR | 0x1
Leer sensor de movimiento. | READ MOTION INSTR | 0x2
Leer sensor de sonido. | READ SOUND INSTR | 0x3
Mover hacia adelante. | MOVE FORWARD | 0x4
Mover hacia atras. ´ | MOVE BACKWARDS | 0x5
Rotar hacia la derecha. | ROTATE RIGHT | 0x6
Rotar hacia la izquierda. | ROTATE LEFT | 0x7

## 3. Medicion de temperatura ´

Como parte de los mecanismos de proteccion, se tiene que se puede monitorear la ´ temperatura de la Raspberry Pi, con el objetivo de que si llegase a pasar cierto umbral que se considere alto, el dispositivo se apague para evitar danos. En este caso se ha definido un ˜ valor peligroso de temperatura para cualquier temperatura mayor a 70 °C. En el codigo del ´
programa de prueba (KROTIC.py) en la opcion 11, se tiene el c ´ | odigo necesario para realizar ´
el monitoreo de temperatura y como apagar la tarjeta si se pasa el umbral.
El comando que mide la temperatura es sudo vcgencmd measure temp y en el codigo ´
luego se toma la parte de la respuesta que interesa utilizando indexacion de ´ | strings y lue-
go si el valor medido es mas alto que el umbral mencionado se ejecuta el comando ´ | sudo
shutdown -h now que apagara la Raspberry inmediatamente. ´

## 4. Transmision en vivo ´

La transmision en vivo se hace a trav ´ | es de la biblioteca motion, que se puede instalar con ´
el comando sudo apt-get install motion, la cual monta un servidor de transmision como ´ proceso que corre como daemon. Ya el servidor se ha configurado, entonces los pasos para levantar el servicio son:
1. Conectarse a internet.
2. Abrir la terminal y escribir el comando hostname -I, esto le dara la IP de la Raspberry. ´
3. Para activar el servidor escribir en la terminal sudo service motion restart o sudo service motion start.
4. Una vez finalice el proceso del comando anterior, escribir en la terminal sudo motion.

5. Para verificar que se haya levantado el servidor entrar al navegadory escribir: <Raspberry IP>:8081. En <Raspberry IP> poner la salida del comando del paso 2 y el puerto por
defecto es el 8081. Al entrar se visualizara lo que est ´ | e capturando la c ´ | amara. ´

Si se necesitara cambiar la configuracion, referirse al siguiente instructivo, (https://www.instructables.com/How-to-Make-Raspberry-Pi-Webcam-Server-and-Stream-/) donde expli- ´ can como levantar el servicio desde cero y donde encontrar los archivos de configuracion. ´ Ahora, por el momento se realiza un streaming que solo es accesible por la red local. Para convertirlo en un servicio que pueda ser accesado en cualquier parte se debe hacer el proceso de redireccionamiento de puertos o port forwarding.
El procedimiento cambia de acuerdo al router que se tenga, por lo que lo mas recomen- ´ dable es contactar a la proveedora de internet para que se asista en el proceso.

## 5. Manejo de camara ´

Si se quiere realizar pruebas con la camara independientemente de la transmisi ´ | | on en ´
vivo, instalar la biblioteca fswebcam y ffmpeg con el comando sudo apt install fswebcam y con sudo apt-get install ffmpeg
1. Para tomar fotos y guardarlas en disco usar el comando fswebcam image.jpg. Des-
pues del comando ´ | fswebcam debe ir el path donde se quiere guardar la foto junto con
el nombre de la foto y su formato, si se quiere guardar en el mismo directorio poner solo el nombre y el formato.
2. Para grabar un video y guardarlo en disco utilizar el comando ffmpeg -f v4l2 -i /dev/video0 -t X output.mp4, donde X es el valor en segundos de la duracion del ´ video.

## 6. Manejo de entradas analogicas en la Raspberry Pi ´

Como la Raspberry Pi es la encarga de manejar la proteccion del sistema, debe medir el ´ nivel de voltaje de las baterías para avisar cuando estas se encuentren cerca de descargar-
se. Esto implica que se deben tomar los valores analogicos de voltaje de las bater ´ | | ías y que
la Raspberry Pi los lea. Los pines de la Raspberry son todos digitales, por lo que se necesita un ADC para poder leer los valores de las baterías correctamente. En el esquematico ´
del diseno, se utiliza un MCP3008 que es bastante com ˜ | un y se tiene mucha informaci ´ | on en ´
diferentes fuentes sobre como manejar el dispositivo.
A grandes rasgos, el ADC es un dispositivo que se comunica con la Raspberry a traves´ del protocolo SPI. Ademas tiene soporte para leer varios dispositivos al mismo tiempo, es- ´ pecíficamente, tiene 8 canales para lectura de datos al mismo tiempo. Los pines no se pusieron en la figura 2 porque puede ser que se utilice otro ADC distinto, entonces eso
quedara para implementaci ´ | on futura. Sin embargo, para leer los valores desde python, se ´
puede utilizar el siguiente codigo: ´

import spide v
import time

# Define V a r i a b l e s

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

#C reate SPI

s p i = spide v . SpiDev ( )
s p i . open( 0 , 0 )

def read adc ( channel ) :
# read SPI data from the MCP3008, 8 channels i n t o t a l i f channel > 7 or channel < 0:

re tu rn −1
r = s p i . xf e r 2 ( [ 1 , 8 + channel << 4 , 0 ] )
data = ( ( r [ 1 ] & 3 ) << 8 ) + r [ 2 ]
re tu rn data

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

La biblioteca externa que se utiliza es spidev y se puede instalar a traves de pip, con el ´ comando pip install spidev.

## 7. Consumo y fuentes de alimentacion´

En cuanto al consumo de energía, la Rasberry Pi es el componente que mas consumo ´ tiene, esto porque si se considera como base la corriente que necesita cuando se esta ac- ´
tiva sin ningun perif ´ | erico conectado, se tienen inicialmente 500 mA, luego se tienen 5 leds ´
indicadores. El consumo de esos LEDs se calcula como:

Iled =

Vrpi − Vled

Rled

(1)

Donde, Vrpi es la salida de voltaje de la Raspberry, que es 3.3V, Vled es la caída de voltaje
del LED, que segun la p ´ | agina donde se hizo la compra tienen una ca ´ | ída de 2.2V y Rled es
una resistencia de 220 Ω. Si se hace el calculo, cada LED necesita 5 mA, y como son cinco, ´ los LEDs abarcan 25 mA.
Luego, los perifericos que m ´ | as corriente necesitan son la c ´ | amara y el adaptador WiFi, ´
que pueden llegar a un maximo de 600 mA cada uno. ´

Si se suman estos valores tenemos que la corriente necesario solo para el nivel superior es de Is = 600 · 2 + 25 + 500 mA, se tiene que Is = 1.7 A.
Por lo que recomendable es utilizar una fuente que provea de al menos 2 A constantes para asegurarse de que todos los servicios funcionan bien.

## 8. Regulacion de voltaje ´

Segun el esquem ´ | atico de la arquitectura, para las entradas de los voltajes que indican ´
el nivel de batería, se utilizaron divisores de voltaje para regular la entrada a los pines de la tarjeta. Recordar que la Raspberry, que es la que maneja todos los LEDs indicadores, soporta no mas de 3.3V ens su pines. ´
Entonces, para el caso de las baterías de los servos. Se usan 4 baterías AA, por lo que cuando estan nuevas pueden llegar a dar alrededor de 6.4 V. El divisor de voltaje para este ´ caso se da con dos resistencias; una de 100kΩ y otra de 107kΩ, el voltaje de entrada para la Raspberry se toma desde la resistencia de 107kΩ que al aplicar el divisor se obtiene:

Vin =

107 · 6,4
100 + 107
= 3,3V. | (2)

Coincidiendo este valor maximo de carga con el valor de referencia del ADC. ´
Para el caso de la batería del Arduino, en su maxima carga tendr ´ | a una salida aproximada ´
de 7.4 V, los valores de resistencia son de 100kΩ y otra cercana al 80.5kΩ tomando la entrada al ADC desde esta ultima resistencia de modo que al aplicar el divisor: ´

Vin =

80,5 · 7,4
100 + 80,5
= 3,3V. | (3)
Para que se tenga que la tension en la carga m ´ | axima coincide con el voltaje de referencia ´
del ADC.
