ShXck/KROTIC-Code/(list of files, drawings)

Other design files:
ConnectionSim.pdsprj
Schematic.fzz
