ShXck/KROTIC-Code/(commit log)

2021-03-29 Proteus project and arduino code
    [ConnectionSim.pdsprj]
2021-03-30 Added motion sensor and I2C Arduino Code and Simulation
    [ConnectionSim.pdsprj]
2021-04-13 Added RPI instruction sender
    [ConnectionSim.pdsprj, Schematic.fzz]
2021-04-13 Updated proteus simulation
    [ConnectionSim.pdsprj]
2021-05-03 Updated arduino code. Protection Module, servo handling
2021-05-18 Changed schematic
    [Schematic.fzz]
2021-06-12 Arduino code updated
    [Schematic.fzz]
2021-06-14 Updated schematic
    [Schematic.fzz]
2021-06-16 Added schematic image
    [Schematic.fzz]
